KCollins/OpenOBS-328/sensor/hardware/PCBA/logger/source/KiCad PCB_OpenOBS_328/PCB_OpenOBS_328p_USB-copy_2026-08-19.kicad_pcb

## KiCad design sensor/hardware/PCBA/logger/source/KiCad PCB_OpenOBS_328/PCB_OpenOBS_328p_USB-copy_2026-08-19.kicad_pcb (2026-08-23)

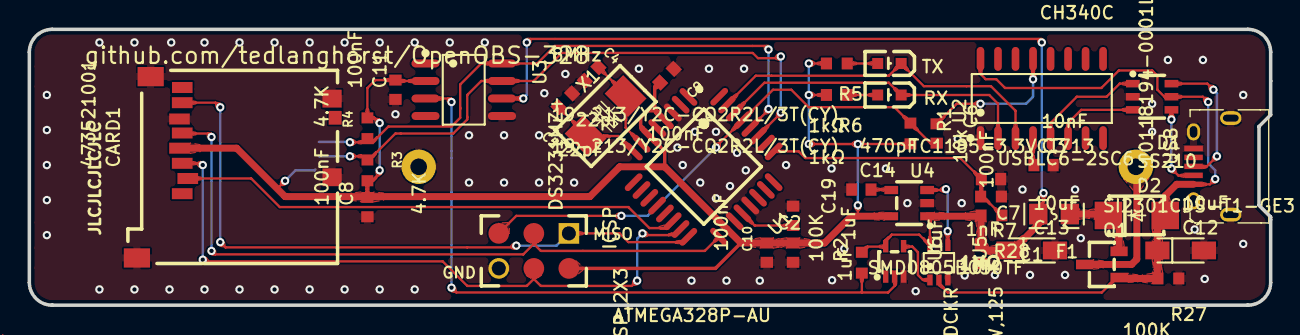
[picture p1: board PCB_OpenOBS_328p_USB-copy_2026-08-19.kicad_pcb from above]

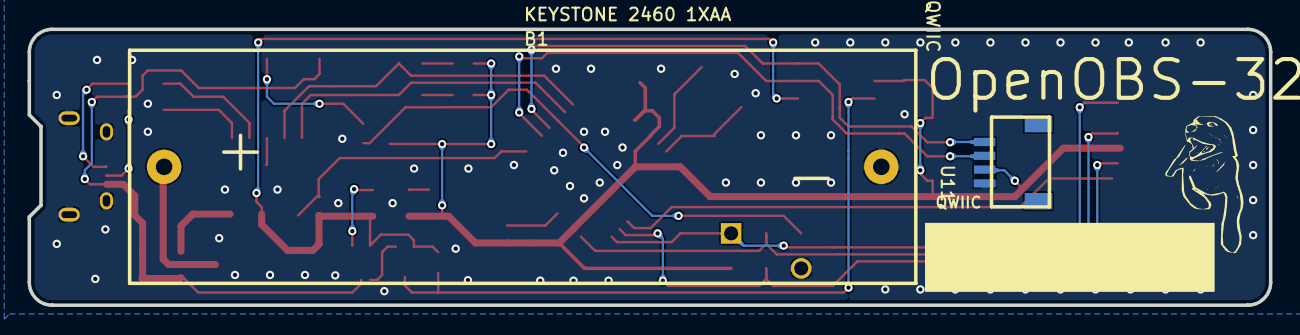
[picture p2: board PCB_OpenOBS_328p_USB-copy_2026-08-19.kicad_pcb from below]

Board: 2 copper layers, 90.0 x 20.0 mm, 42 parts (2 on the bottom side), 31 nets.

Parts:
B1: KEYSTONE 2460 1XAA
C1, C2, C19: 1uF; C0603
C3: 10nF; C0603
C4, C5: 22pF; C0603
C6, C8, C9, C10, C11: 100nF; C0603
C7: 1nF; C0603
C12, C13: 10uF; CAP-SMD_L3.2-W1.6-R-RD
C14: 470pF; C0603
CARD1: 473521001; SD-SMD_SD-47352-101
D1: USBLC6-2SC6; SOT-23-6_L2.9-W1.6-P0.95-LS2.8-BR
D2: SS210; SMA_L4.3-W2.6-LS5.2-RD
F1: SMD0805B050TF; F0805
ICSP: ICSP_2X3; CON2X3
Q1: SI2301CDS-T1-GE3; SOT-23-3_L3.0-W1.7-P0.95-LS2.9-BR
R1: 10k; R0603
R2, R27: 100K; R0603
R3, R4: 4.7K; R0603
R5, R6: 1kΩ; R0603
R7: 1MΩ; R0603
R28: 10M; R0603
RX: 19-213/Y2C-CQ2R2L/3T(CY); LED0603-R-RD
TX: 19-213/Y2C-CQ2R2L/3T(CY); LED0603-R-RD
U1: ATMEGA328P-AU; TQFP-32_L7.0-W7.0-P0.80-LS9.0-BL
U2: CH340C; SOP-16_L10.0-W3.9-P1.27-LS6.0-BL
U3: DS3231MZ+; SOIC-8_L4.9-W3.9-P1.27-LS6.0-BL
U4: TC1185-3.3VCT713; SOT-23-5_L3.0-W1.7-P0.95-LS2.8-BR
U5: 74AHC1G32GW,125; SOT-353_L2.2-W1.4-P0.65-LS2.4-BR
U6: SN74LVC1G14DCKR; SC-70-5_L2.1-W1.3-P0.65-LS2.1-BR
U11: QWIIC; QWIIC CONNECTOR
USB: 10118194-0001LF; MICRO-USB-SMD_10118194-0001LF
X1: 8MHz; CRYSTAL-SMD_L5.0-W3.2

Connections:
C4_1: C4.1, U1.7, X1.2
C5_2: C5.2, U1.8, X1.1
C19_2: C19.2, U1.20
CS: CARD1.2, U1.14
GND: B1.2, C1.1, C2.2, C3.2, C4.2, C5.1, C7.1, C8.1, C9.1, C10.1, C11.1, C12.2, C13.2, C14.1, C19.1, CARD1.6, CARD1.EH, D1.2, ICSP.6, R7.1, R27.1, U1.3, U1.5, U1.21, U2.1, U3.5, U4.2, U5.3, U6.3, U11.1, USB.5, USB.6
MISO: CARD1.7, ICSP.1, U1.16
MOSI: CARD1.3, ICSP.4, U1.15
PINTERRUPT: R2.1, U3.3, U6.2
PRESET: C6.2, ICSP.5, R1.1, U1.29
Q1_2: D2.1, F1.1, Q1.2
R28_1: C7.2, R7.2, R28.1, U1.25
RX: RX.2, U1.30, U2.2
RX_1: R6.1, RX.1
SCK: CARD1.5, ICSP.3, U1.17
SCL: R4.1, U1.28, U3.8, U11.4
SDA: R3.1, U1.27, U3.7, U11.3
TX: TX.2, U1.31, U2.3
TX_1: R5.1, TX.1
U2_4: C3.1, U2.4
U2_5: D1.1, U2.5
U2_6: D1.3, U2.6
U2_13: C6.1, U2.13
U4_4: C14.2, U4.4
U5_1: U5.1, U6.4
U5_4: U4.3, U5.4
USB_2: D1.4, USB.2
USB_3: D1.6, USB.3
VBAT: B1.1, Q1.3
VCC: C2.1, C8.2, C9.2, C10.2, C11.2, CARD1.4, ICSP.2, R1.2, R3.2, R4.2, R5.2, R6.2, U1.4, U1.6, U1.18, U3.2, U4.5, U11.2
VIN: C1.2, C13.1, F1.2, R2.2, R28.2, U3.6, U4.1, U5.5, U6.5
VUSB: C12.1, D1.5, D2.2, Q1.1, R27.2, U2.16, U5.2, USB.1
