KCollins/OpenOBS-328/(commit log)

2026-08-23 Zipped EasyEDA files and created KiCad version.
2026-08-23 KiCad port. WIP.
    [PCB_OpenOBS_328p_USB-copy_2026-08-19.kicad_pcb, PCB_OpenOBS_328p_USB-copy_2026-08-19.kicad_sch]
2026-08-23 KiCad port archive. WIP.
2026-10-20 Create vcnl_universal_logger.ino
    Updated logger that should allow for all VCNL sensors and both continuous and long-term logging. Under test.
2026-10-20 Update launch.html
    Got rid of battery estimation; current settings should now be restricted to whatever the options actually are for a given sensor.
